Arshyi/Steady/(commit log)

2026-11-07 Add Steady web dashboard and wearable firmware
    - Vite + React + TypeScript + Tailwind web app
    - Landing page positioning Steady as wearables plus a live dashboard
    - Overview with fall alerts and a wing map, Alerts page, Residents device metrics
    - Settings for hardware diagnostics and pairing over Bluetooth, USB or a simulator
    - Arduino starter firmware for the wearable (IMU streaming, fall detection, identify)
    - unslop design skill for Claude Code
2026-11-07 Add the UNO Q as a wearable: Qwiic IMU sketch, Bridge-to-WebSocket app, network transport.
    The existing wearable firmware needs ArduinoBLE and an onboard IMU, neither of which the UNO Q sketch can use; here the STM32 reads a Modulino Movement over Qwiic and hands 50 Hz samples plus fall events to the Linux side over the Bridge, which serves them over WebSocket. Settings gains a network transport beside Bluetooth and USB, sharing the same protocol contract, so a device can stay on the ward network instead of a cable.
    Generated with Codebuff 🤖
2026-11-08 Add I'm OK, survey-mode room location and NFC response taps
    The wearable gets a button and an optional PN532 reader: one press sends
    "I'm OK", three presses start a Wi-Fi survey, and a staff tag tap records a
    response. The UNO Q's Linux side runs the scans (nmcli/iw/iwlist), posts them
    to the Worker in web/, and labels them with a room and floor from Settings.
    Later scans are matched against the stored fingerprints, so a fall can show
    the room and floor. An OK press or tag tap also clears the paired resident's
    open alert on the dashboard.
2026-11-08 Connect dashboard to Databricks with simulated and live device data
2026-11-08 Keep Vite from reloading on wrangler's local state
    wrangler dev rewrites its D1 and trace-store SQLite files on every request,
    and Vite watched web/.wrangler as project source, so it full-reloaded the
    dashboard roughly every 45 seconds. That dropped any connected wearable and
    the in-page pairing and alert state with it.
2026-11-08 Add the MPU6050 wearable firmware and its host tests
    The sensor-side stack: an MPU6050 driver, orientation and fall-detector
    modules over a window buffer, a Python pipeline and uplink, and a host
    test harness that exercises the detector on a desktop. Compiled output
    stays out of git.
2026-11-08 Add Wi-Fi connection for UNO Q and mock relay
2026-11-08 Remove Overview and move wing summary to Alerts
2026-11-08 Integrate the wearable uplink with the dashboard
    The UNO Q posts its batched uplink to POST /api/v1/ingest, which the dashboard server now accepts: samples are folded into one reading per second and fall events become alerts carrying the peak g and posture change. Adds a local store so the whole path runs without Databricks, a firmware-format device simulator (npm run sim:device), and a Settings list of the wearables that have reported in so they can be paired.
    🤖 Generated with Codebuff
2026-11-08 Add an Arduino UNO accelerometer path for hardware demos
    Settings can now connect to a board over USB using Web Serial, reading the same text protocol the UNO Q relay uses, so the dashboard shows a real accelerometer. The included sketch reads an analog 3-axis sensor on A0-A2 and derives rotation rates from it. Device mode gains demo fill so the rest of the wing keeps dummy readings and vitals around the one real sensor.
    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
2026-11-08 Read the MPU6050's real gyroscope over I2C
    The demo sketch now talks to an MPU6050 directly instead of sampling analog accelerometer pins, so the gyroscope the dashboard plots is real rather than derived from the gravity vector. Adds a zero-rate bias calibration at startup and a diagnostic line when the sensor is missing.
    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
    [steady_mpu6050.ino]
2026-11-08 Detect falls on the board and carry them into the dashboard alert
    The sketch sampled the sensor at the same rate it printed, so a drop's impact spike usually fell between samples and no fall was ever raised. Sample at 200 Hz for detection while printing at ~40 Hz, lower the impact gates, and send the measured peak g and posture change through the existing /api/falls path so the alert says what the device saw.
    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
2026-11-08 Consolidate the six component READMEs into one project README.
    The docs had drifted apart across arduino, firmware, hardware, server and web, so the root README is now the single source for wiring, flashing, the protocol, fall detection, the dashboard, the server and the Worker.
    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
    [sketch.ino]
2026-11-08 Mark the Wi-Fi relay path as unproven in the README.
    The board's wlan0 has never joined a network and the App Lab app was never installed, so only the USB serial path has run on hardware; say so instead of implying Wi-Fi is verified.
    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
2026-11-08 Record what the board's Wi-Fi actually does.
    It associates with the campus network and takes a DHCP lease, but a Cisco ISE guest portal intercepts every request, so the relay still has not run on hardware; replace the earlier claim that wlan0 had never joined anything.
    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
2026-11-08 Run the Wi-Fi relay on the board for real.
    The App Lab app now builds, starts and streams the MPU6050 over the network: the
    sketch probes both I2C buses (A4/A5 on the UNO Q is Wire2, so Wire-only never found
    the IMU), app.yaml publishes 8765 with the integer ports list the descriptor parser
    accepts, and the optional PN532 library no longer breaks the sketch build. Verified
    on the UNO Q: ws://10.200.113.130:8765 streams ~48 samples/s, the dashboard connects
    over Wi-Fi, and readings reach server/ once the board is paired.
    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
    [sketch.ino]
2026-11-08 Document how the app comes back after a reboot.
    The App CLI daemon starts at boot but apps do not, so a reboot left the relay
    closed until someone started the app by hand. Record the @reboot crontab entry and
    the retry script that replaces that manual step, plus the fact that the board's
    arduino user has no reboot privilege at all.
    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
2026-11-08 Restructure the README for readability.
    The document had grown by appending whole READMEs, so the Wi-Fi relay - now the
    main hardware path - sat inside "Other firmware builds", and a table of contents
    could not be trusted. Give it a contents list, an at-a-glance status table, a
    quick start before the deep detail, and one section per component, with the App
    Lab app split into verified/gotchas/autostart. Every threshold, command, endpoint
    and error string is carried over unchanged.
    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
2026-11-08 Drive the button's second leg from D4 instead of requiring a GND wire.
    The pushbutton is now wired across D2 and D4, so hold D4 low and read D2 against
    its pull-up: a press shorts the pair and reads LOW, and the old D2-to-GND wiring
    still behaves identically. Document the pinout, the gestures and the PN532 reset
    pin that shares D4, and bump the firmware so the relay and server report the
    build that is actually running.
    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
    [sketch.ino]
2026-11-08 Let a relay refresh its firmware version on every reading.
    /api/readings discarded the version, so a device kept showing whatever build first
    registered - the board now runs 1.2.1 while the store still said 1.2.0. Pass an
    optional firmware through to touchDevice and have the relay send its own.
    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
2026-11-08 Type the firmware a relay may report, so the previous commit compiles.
    The /api/readings handler read r.firmware, but DeviceReading did not declare it and
    tsc -b failed. Add the optional field rather than widening the type at the call site.
    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
2026-11-08 Keep the sketch's version example in step with the firmware it now reports.
    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
2026-11-08 Record what the button actually did on hardware.
    One press clears the resident's open alerts and the server names "I'm OK button" as
    the handler; three presses reach the survey path. The survey scan itself still comes
    back empty because the App Lab container has no nmcli, iw or D-Bus, so say so rather
    than leaving the button untested in the docs.
    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
2026-11-08 Keep a fall open when the wearer presses I'm OK.
    Pressing the button used to set handled_at, so the alert left the queue and the
    notification disappeared - the opposite of what a fall needs. It now records
    acknowledged_at and only changes the alert's urgency, leaving staff to resolve it.
    Falls get a computed three-tier urgency: no movement at all since the fall is the
    top tier (and outranks a press), unacknowledged is next, and a press is the lowest.
    Urgency ignores the demo fill stream, which used to look like the resident moving.
    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
2026-11-08 Add staff accounts with Auth0, care home registration and live-mode cleanup
    - Staff log in through Auth0. Accounts come only from registering a care home
    (its first admin) or an admin's invite; Auth0 emails a set-password link.
    - New Staff page for admins: invite, resend, change role, remove. A care home
    always keeps at least one administrator.
    - The server checks every staff request. Caretakers can view, handle alerts and
    pair devices; changing the data source and the demo fall are admin only.
    "Handled by" records the signed-in person. Device routes keep their token.
    - Login is off when the Auth0 settings are empty, so local demos still work.
    - Home page: new headline and copy, staf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
2026-11-08 Document the four-minute hackathon pitch.
    Adds docs/hackathon-pitch.md: run of show, slide copy, the spoken script, demo
    choreography, a sourced comparison of pendants, bed-exit alarms, clinical alarms,
    consumer watches, cameras and RTLS, the Databricks write/read workflow, and the
    NFC and location claims with the limits stated next to them.
    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
2026-11-08 Keep the pitch document out of the repository.
    The pitch is a presentation aid rather than project source, so it belongs with
    the presenter, not in the tree.
    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
2026-11-08 Use ±8 g on both sketches and read the relay's server address from config.json
    - At ±2 g the accelerometer could never report the impacts the fall rules
    need (2.6/3.5 g on the Wi-Fi sketch, 3.0 g on the USB one). Both sketches
    now use ±8 g; thresholds are in g, so they stay as they are.
    - The relay no longer has one laptop's address in the code. It reads
    server_url from python/config.json (git-ignored, see config.example.json)
    or STEADY_SERVER_URL, and prints where it is sending.
    - README: ±8 g, the config file, and WSL mirrored networking.
    [sketch.ino, steady_mpu6050.ino]
2026-11-08 Add residents from pairing, drop firmware from the UI, and let I'm OK resolve a fall
    - Pairing has "+ Add a new resident": type a name (and optional room), then
    Add and pair. New POST /api/residents on both stores. Residents added this
    way have no simulated device, so they only appear in live mode.
    - Firmware is gone from every screen: device tables, the connect panel, the
    resident page and the "Firmware out of date" issue. The server still keeps
    the version internally.
    - Pressing I'm OK on the wearable resolves the resident's open fall: it moves
    to Handled tonight "via I'm OK button" and Undo reopens it.
    - The pairing confirmation shows straight away instead of after the next poll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
2026-11-08 Make Wi-Fi fall detection work, add status lights, keep demo residents out of live mode
    - The Wi-Fi sketch now uses the USB sketch's drop-tested rules (weightless,
    then over 1.8 g within 1.2 s, then a 40° posture change or a 3.0 g hit) in a
    shared fall_detector.h, checked every 5 ms with the sensor at 200 Hz. It used
    to check every 20 ms and need 2.6 g after 100 ms of free fall, which drops
    onto a cushion or bed never reached. Laptop tests in tools/fall_detector_test.cpp.
    - Falls carry peak g and posture change to the relay and on to the server, so
    the alert says what the board measured.
    - Settings: removed the Devices in Wing A table; Wearables reporting in shows a
    green light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
2026-11-08 Mark a fall handled when a worker taps the NFC tag.
    A tag tap is a worker proving they responded at the bedside, so it now resolves the
    resident's newest open fall instead of only lowering its urgency. The wearer's
    "I'm OK" press keeps its existing meaning: downgrade the tier, leave the fall open.
    Both stores report whether the tap actually closed something.
    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
    [sketch.ino]
2026-11-08 Fix fall alerts never saving to Databricks, and add a live gyroscope graph
    - insertAlerts listed 8 values for a table that now has 10 columns (the I'm OK
    change added acknowledged_at/by), so Databricks rejected every new alert:
    falls, checks and battery. It now names its columns.
    - The relay and the browser send each second's raw readings with the summary.
    The server keeps the last 15 s in memory (not Databricks) and serves them at
    GET /api/live/:deviceId; a resident's page draws a live gyroscope graph from it.
2026-11-08 Avoid acosf in the fall detector
    The UNO Q build failed at the link step (undefined arduino::String, Serial2,
    _exit) after the detector started using acosf. Compute the posture angle with
    a sqrtf-based approximation instead (within 0.004°); detector tests unchanged.
    [fall_detector.h]
2026-11-08 Revert the upstream merge
    The merged changes reinterpret what the I'm OK button means. The button
    should stay a confirmation that lowers urgency, and the branch should
    match fb28ff4, so this reverts 2eb0a31.
    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
    [fall_detector.h, sketch.ino, steady_mpu6050.ino]
2026-11-08 Make the button a worker response confirmation
    A press now records "Worker responded" instead of "I'm OK button", and the
    urgent and watch labels say "No worker yet" and "Worker responded". The
    fall still stays open and only drops a tier; Mark checked remains the
    action that closes it. Firmware, simulator and README copy follow.
    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
2026-11-08 Add a demo tools page to reset live devices and accounts
    /demo shows what live mode and Auth0 hold, and can:
    - reset live devices: staff-added residents, all pairings, live alerts, the
    in-memory list of wearables, and optionally live readings (simulated data
    stays), so pairing can be shown from the start
    - delete every Auth0 login and sign this browser out, so registering a care
    home and inviting staff can be shown again; also clears the register limit
    The server only accepts /api/demo from loopback (this computer) and resets
    need an x-steady-demo header, so other websites can't trigger them.
2026-11-08 Condense the README to the current product
    The README had grown to 495 lines with duplicated history and detail.
    This keeps the wiring, triage tiers, protocol, server, relay, Worker,
    troubleshooting and limits in a shorter reference.
    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
2026-11-08 Restore the fall fixes, live graph and residents work that the revert removed
    f0149fa reverted the whole upstream merge to settle what the button means, which
    also took out work unrelated to the button:
    - the alerts insert fix: without it Databricks rejects every new alert, so falls
    never reach the dashboard
    - fall detection that fires (fall_detector.h, 5 ms checks, ±8 g on both sketches)
    - the live gyroscope graph, adding residents while pairing, status lights, live
    mode showing only staff-added residents, firmware removed from the UI
    - python/config.json for the relay's server address
    This brings all of it back. Main's later commits stay: the "Worker responded"
    wording and the conden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
    [fall_detector.h, sketch.ino, steady_mpu6050.ino]
2026-11-08 Let a press on the wearable resolve the fall again
    A worker pressing the button once now moves the resident's open fall to Handled
    tonight as "Worker responded" (Undo reopens it), keeping the wording from
    d0caf1f. Staff can still resolve a fall with Mark checked.
2026-11-08 Stop Databricks hangs freezing the server, and make the demo account reset reliable
    - Databricks requests had no time limit. After the laptop changed Wi-Fi, a dead
    connection left them waiting forever and froze every request that touched
    Databricks, including the demo page. Requests now give up after 45 s,
    statements after 2 min (and are cancelled), and the CLI token call after 30 s.
    - /api/demo/status reads live counts and accounts separately, so a slow
    Databricks can't block the account list (and with it the delete button).
    - The account list includes accounts created in the last minute that Auth0's
    search hasn't indexed yet, so register-then-reset deletes them too.
    - After delet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
2026-11-08 Retry Databricks requests on a fresh connection after a network change
    When the laptop switched Wi-Fi, the server kept reusing dead connections to
    Databricks: each request now waited out the 45 s limit and the next one picked
    up another dead connection, so the dashboard showed "Not connected to
    Databricks" until a restart. Requests now wait at most 15 s and retry up to
    three times; aborting drops the dead connection, so the retry opens a new one
    and the server recovers by itself within seconds.
